LefferTrochez/ROBOTICA/Costs/Costs.xlsx

 | #VALUE!
 |  |  | DuqueXII: Costs
 | Consideraciones: | * Todos los precios se encuentran sin su corresponiente costo de envío.
 |  | * La tasa de cambio aproximada para Diciembre de 2024 es:
 |  | $4370 | COP | por | $1 | USD
 | Total |  |  | $3911647 | $895.11
No. | Componente Electrónico | Cantidad | Precio [COP] | Total [COP] | Total [USD]
1 | YDLidar X4 | 1 | $450772 | $450772 | $103.15
2 | Cargador Jetson Nano 5V - 2A | 1 | $17056 | $17056 | $3.90
3 | Jetson Nano B01 | 1 | $1071000 | $1071000 | $245.08
4 | 128 SD Card Jetson Nano | 1 | $70000 | $70000 | $16.02
5 | Arduino Nano 33 BLE Sense rev2 | 1 | $238000 | $238000 | $54.46
6 | Ventilador PWM Jetson Nano | 1 | $32698 | $32698 | $7.48
7 | Wireless AC8265 Wifi y Bluetooth | 1 | $86503 | $86503 | $19.79
8 | Cámara 12MP Arducam | 1 | $489455 | $489455 | $112.00
9 | Tornillos 3 mm | 40 | $100 | $4000 | $0.92
10 | LED IR Transmisor 5 mm | 10 | $500 | $5000 | $1.14
11 | Buzzer Pasivo 24V | 1 | $8000 | $8000 | $1.83
12 | Puente Eléctrico Jetson Nano | 1 | $800 | $800 | $0.18
13 | Toma C14 con Switch | 1 | $8000 | $8000 | $1.83
14 | Fusible 20A | 1 | $3000 | $3000 | $0.69
15 | Condensador Electrolítico 1uF 50V | 2 | $200 | $400 | $0.09
16 | Transistor 2N2222A | 8 | $400 | $3200 | $0.73
17 | LED IR Receptor 5 mm | 6 | $800 | $4800 | $1.10
18 | Diodo Rectificador 1N4004 | 7 | $200 | $1400 | $0.32
19 | Resistencias | 36 | $100 | $3600 | $0.82
20 | Cable 250V C14 | 1 | $7000 | $7000 | $1.60
21 | Diodo Rectificador M10 10A10 | 3 | $1000 | $3000 | $0.69
22 | LED Potencia 3W | 2 | $3000 | $6000 | $1.37
23 | Batería Litio-Ion 18650 | 3 | $32963 | $98889 | $22.63
24 | BMS 3S 20A | 1 | $30000 | $30000 | $6.86
25 | Sensor MQ-135 | 1 | $9996 | $9996 | $2.29
26 | Fuente de Alimentación 12V 10A | 1 | $72108 | $72108 | $16.50
27 | Regulador Setp-Down XL4016 | 2 | $30000 | $60000 | $13.73
28 | Filamento 3D PET-G | 2 | $80000 | $160000 | $36.61
29 | Cámara Térmica AMG8833 IR | 1 | $144990 | $144990 | $33.18
30 | Antena 2.4GHz 3dB | 2 | $7990 | $15980 | $3.66
31 | Parlante 4Ohm 3W | 2 | $14990 | $29980 | $6.86
32 | Micro Servo MG90S | 2 | $9080 | $18160 | $4.16
33 | Servo MG996R | 2 | $28947 | $57894 | $13.25
34 | Mini Ventilador 5V | 2 | $5090 | $10180 | $2.33
35 | Adaptador USB a Jack 3.5 mm | 1 | $26900 | $26900 | $6.16
36 | Amplificador Digital 3W 5V | 1 | $5000 | $5000 | $1.14
37 | Conector Eléctrico Giratorio 360° | 1 | $145986 | $145986 | $33.41
38 | LEDs RGB 5mm | 20 | $700 | $14000 | $3.20
39 | Rele 5V | 1 | $3000 | $3000 | $0.69
40 | Regleta Macho 2.5" | 1 | $1500 | $1500 | $0.34
41 | Regleta Hembra 2.5" | 1 | $2000 | $2000 | $0.46
42 | Pegamento (Superbonder) | 1 | $3000 | $3000 | $0.69
43 | Baquela Perforada Grande | 3 | $7000 | $21000 | $4.81
44 | Baquela Perforada Pequeña | 2 | $2000 | $4000 | $0.92
45 | Cable Calibre 14 | 3 | $4500 | $13500 | $3.09
46 | Conector Jack Barril 5V DC | 1 | $3700 | $3700 | $0.85
47 | Transistor IRFZ44N | 1 | $2900 | $2900 | $0.66
48 | Capacitor 1pF | 2 | $250 | $500 | $0.11
49 | Microfono Digital | 1 | $15000 | $15000 | $3.43
50 | Conector 3.5mm Estereo | 1 | $2100 | $2100 | $0.48
51 | Capacitor 4700uF | 4 | $6500 | $26000 | $5.95
52 | Circuito Integrado LM3915N | 1 | $3400 | $3400 | $0.78
53 | Bornera LM3915N | 1 | $1200 | $1200 | $0.27
54 | Inductor 100uH 5A | 2 | $6300 | $12600 | $2.88
55 | Potenciometro 20K | 1 | $1500 | $1500 | $0.34
56 | Goma Antideslizante | 1 | $21000 | $21000 | $4.81
57 | Fabricación de PCBs | 9 | $39500 | $355500 | $81.35
58 | LEDs 5mm | 10 | $450 | $4500 | $1.03
